ckflight/RF_SIGNAL_GENERATOR_HARDWARE/README.md

# RF_SIGNAL_GENERATOR_HARDWARE

MAX2871 23.5 to 6000MHz RF Signal Generator design with ATMEGA32U4 MCU, Filter Bank and Power Amplifier.

signal generator
