ckflight/RF_SIGNAL_GENERATOR_HARDWARE/RF Signal Generator.pdf

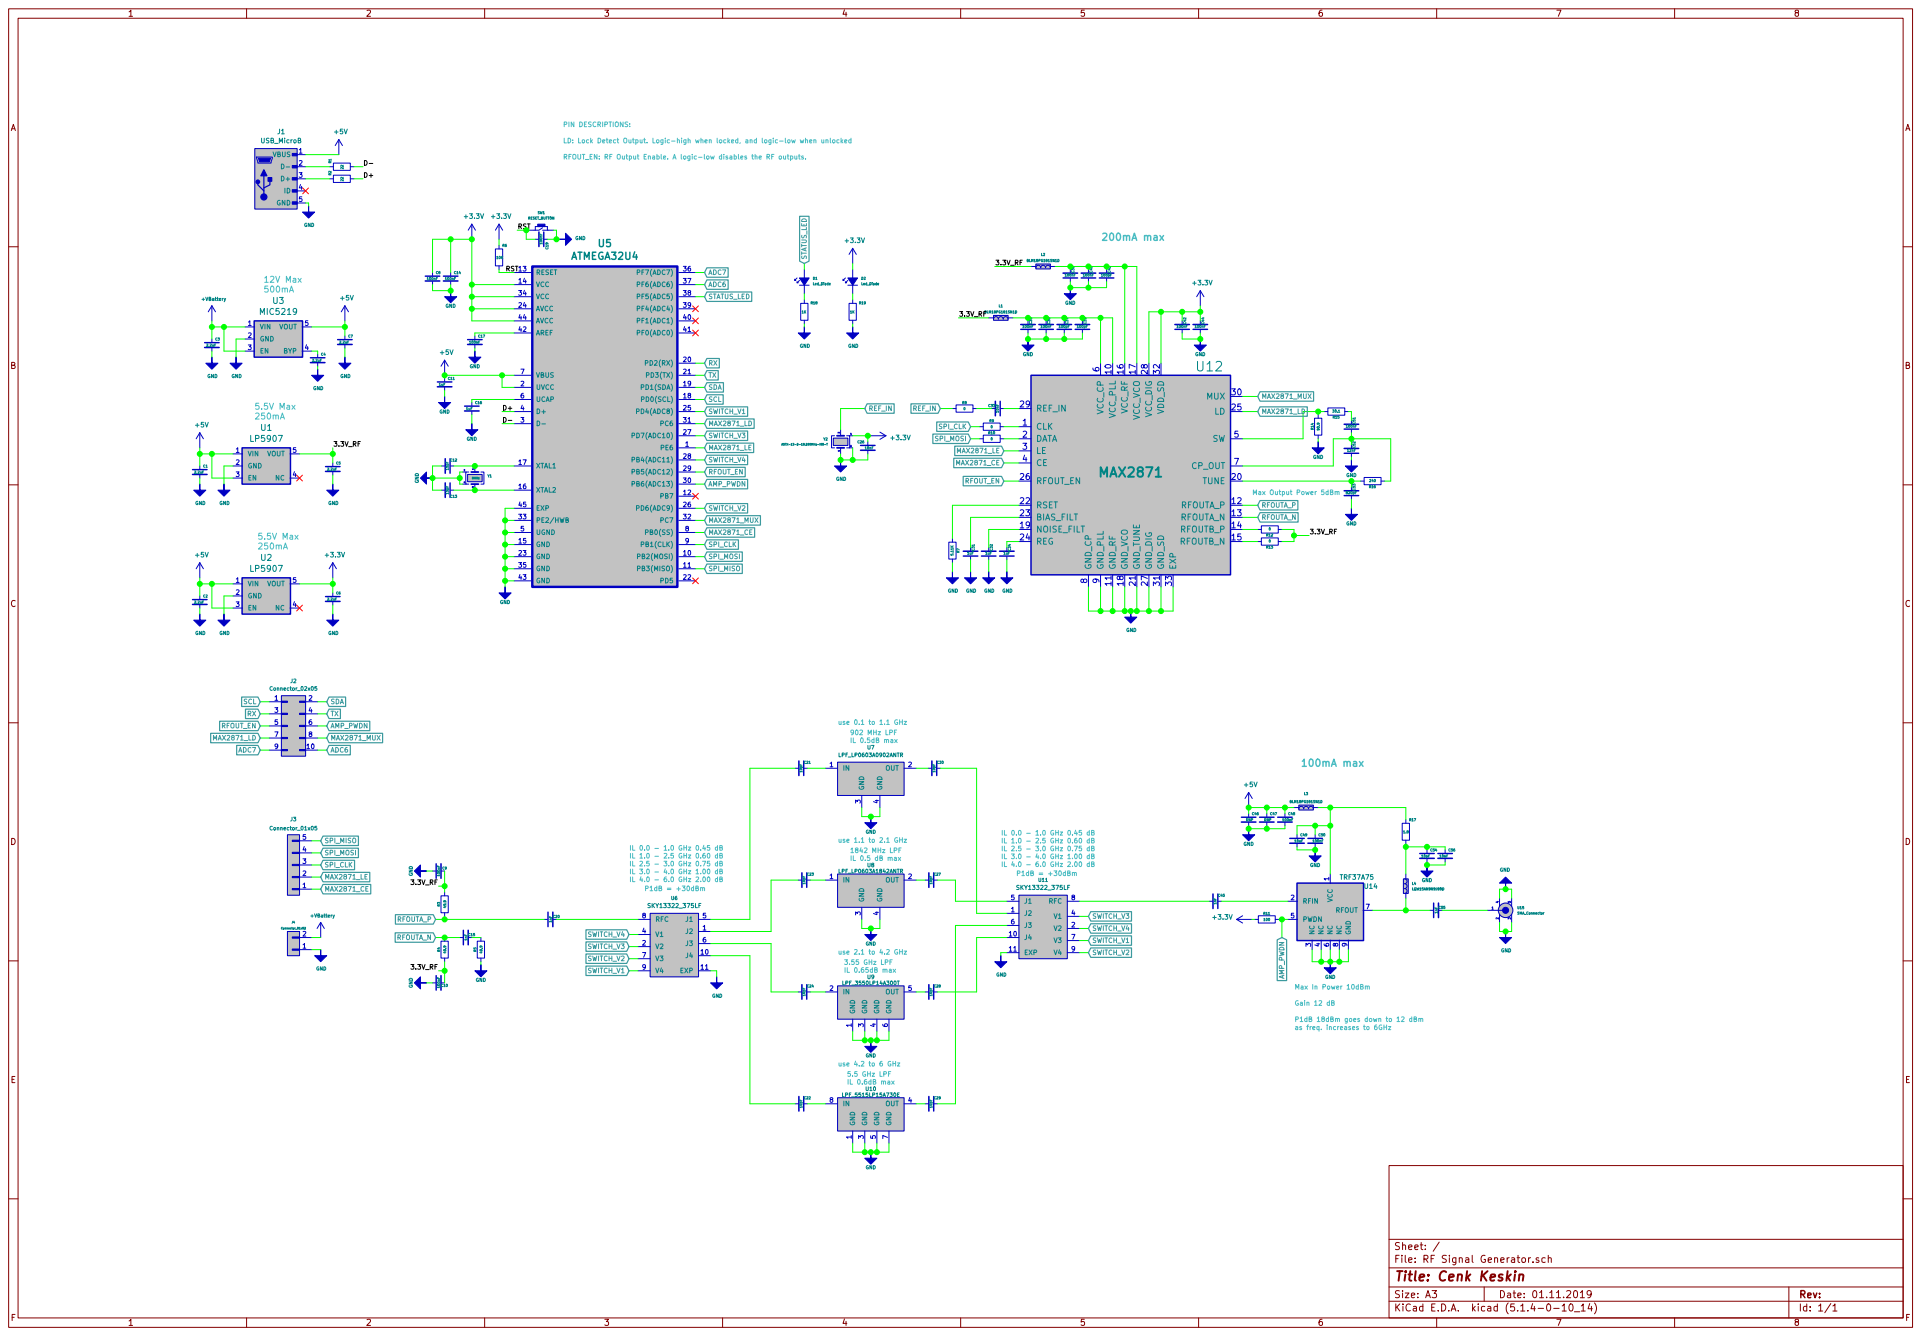
[picture p1: page 1]

PIN DESCRIPTIONS: LD: Lock Detect Output. Logic-high when locked, and logic-low when unlocked RFOUT_EN: RF Output Enable. A logic-low disables the RF outputs.

use 1.1 to 2.1 GHz 902 MHz LPF
IL 0.5dB max 5.5 GHz LPF

4 U7 LPF_LP0603A0902ANTR GND
use 4.2 to 6 GHz use 2.1 to 4.2 GHz 1842 MHz LPF
IL 0.5 dB max

P1dB 18dBm goes down to 12 dBm
as freq. increases to 6GHz

File: RF Signal Generator.sch Sheet: /
Id: 1/1 Title: Cenk Keskin
