ckflight/RF_SIGNAL_GENERATOR_HARDWARE/RF Signal Generator.kicad_pcb

## KiCad design RF Signal Generator.kicad_pcb (2020-02-22)

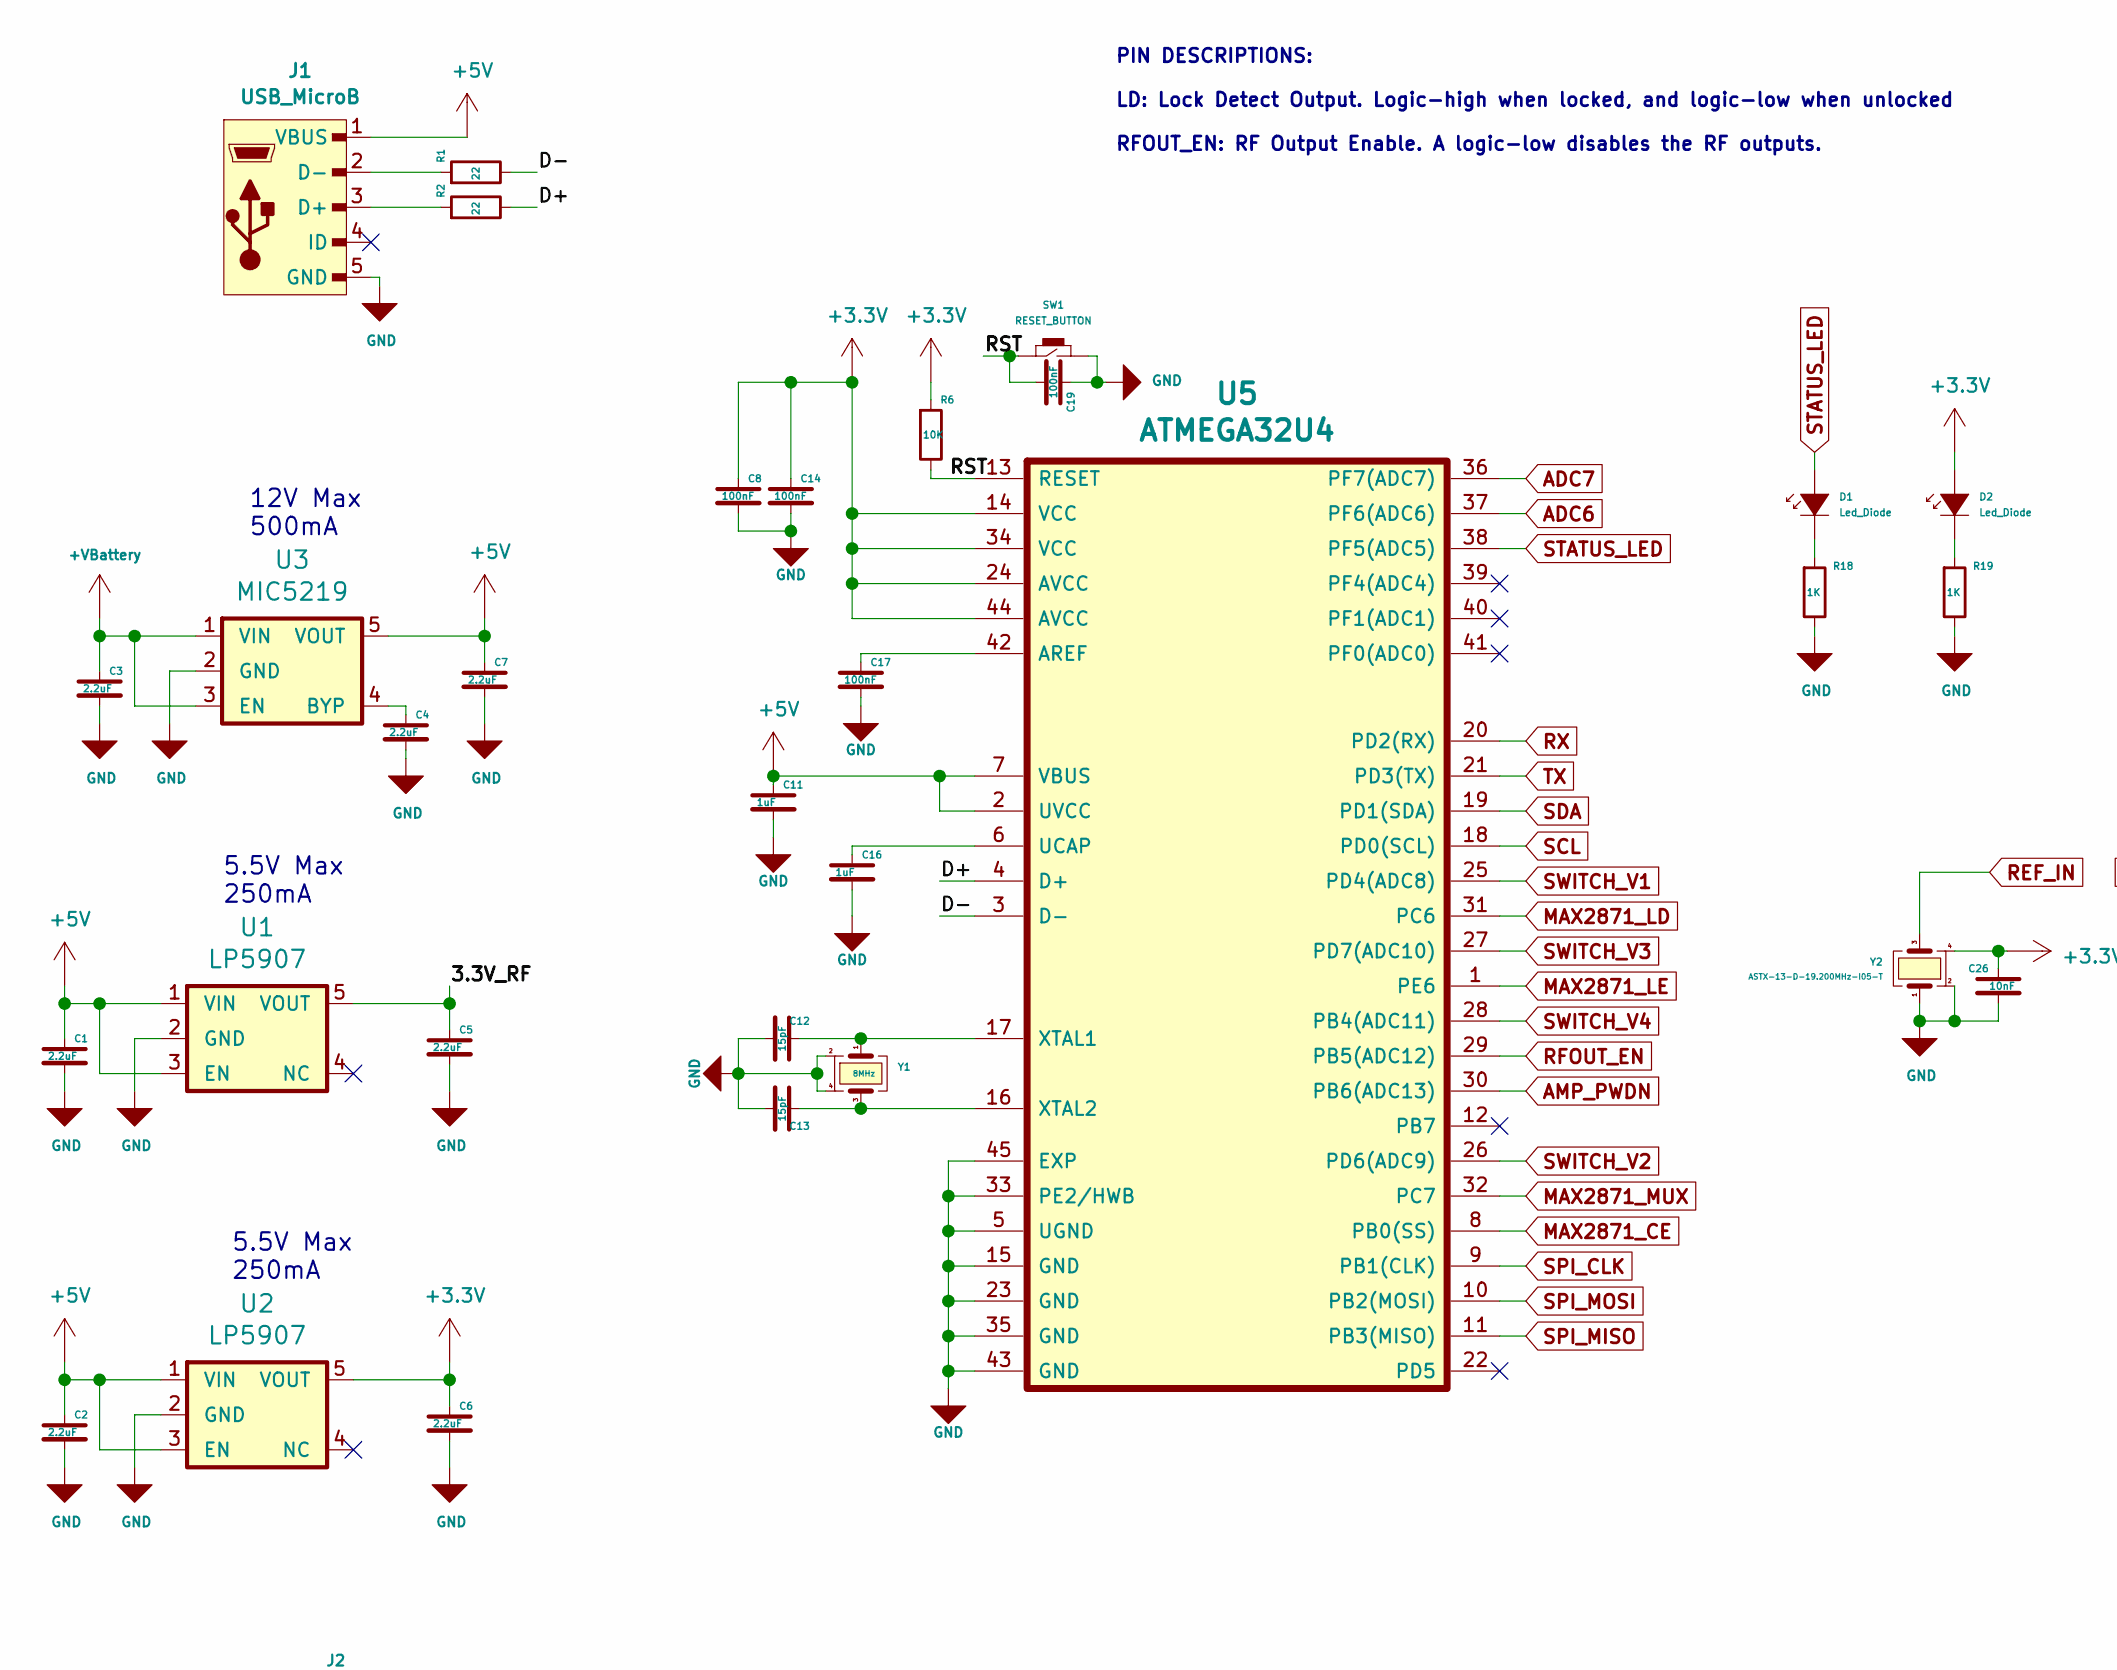
[picture p2: schematic RF Signal Generator.sch, Cenk Keskin, part in row 1, column 1]

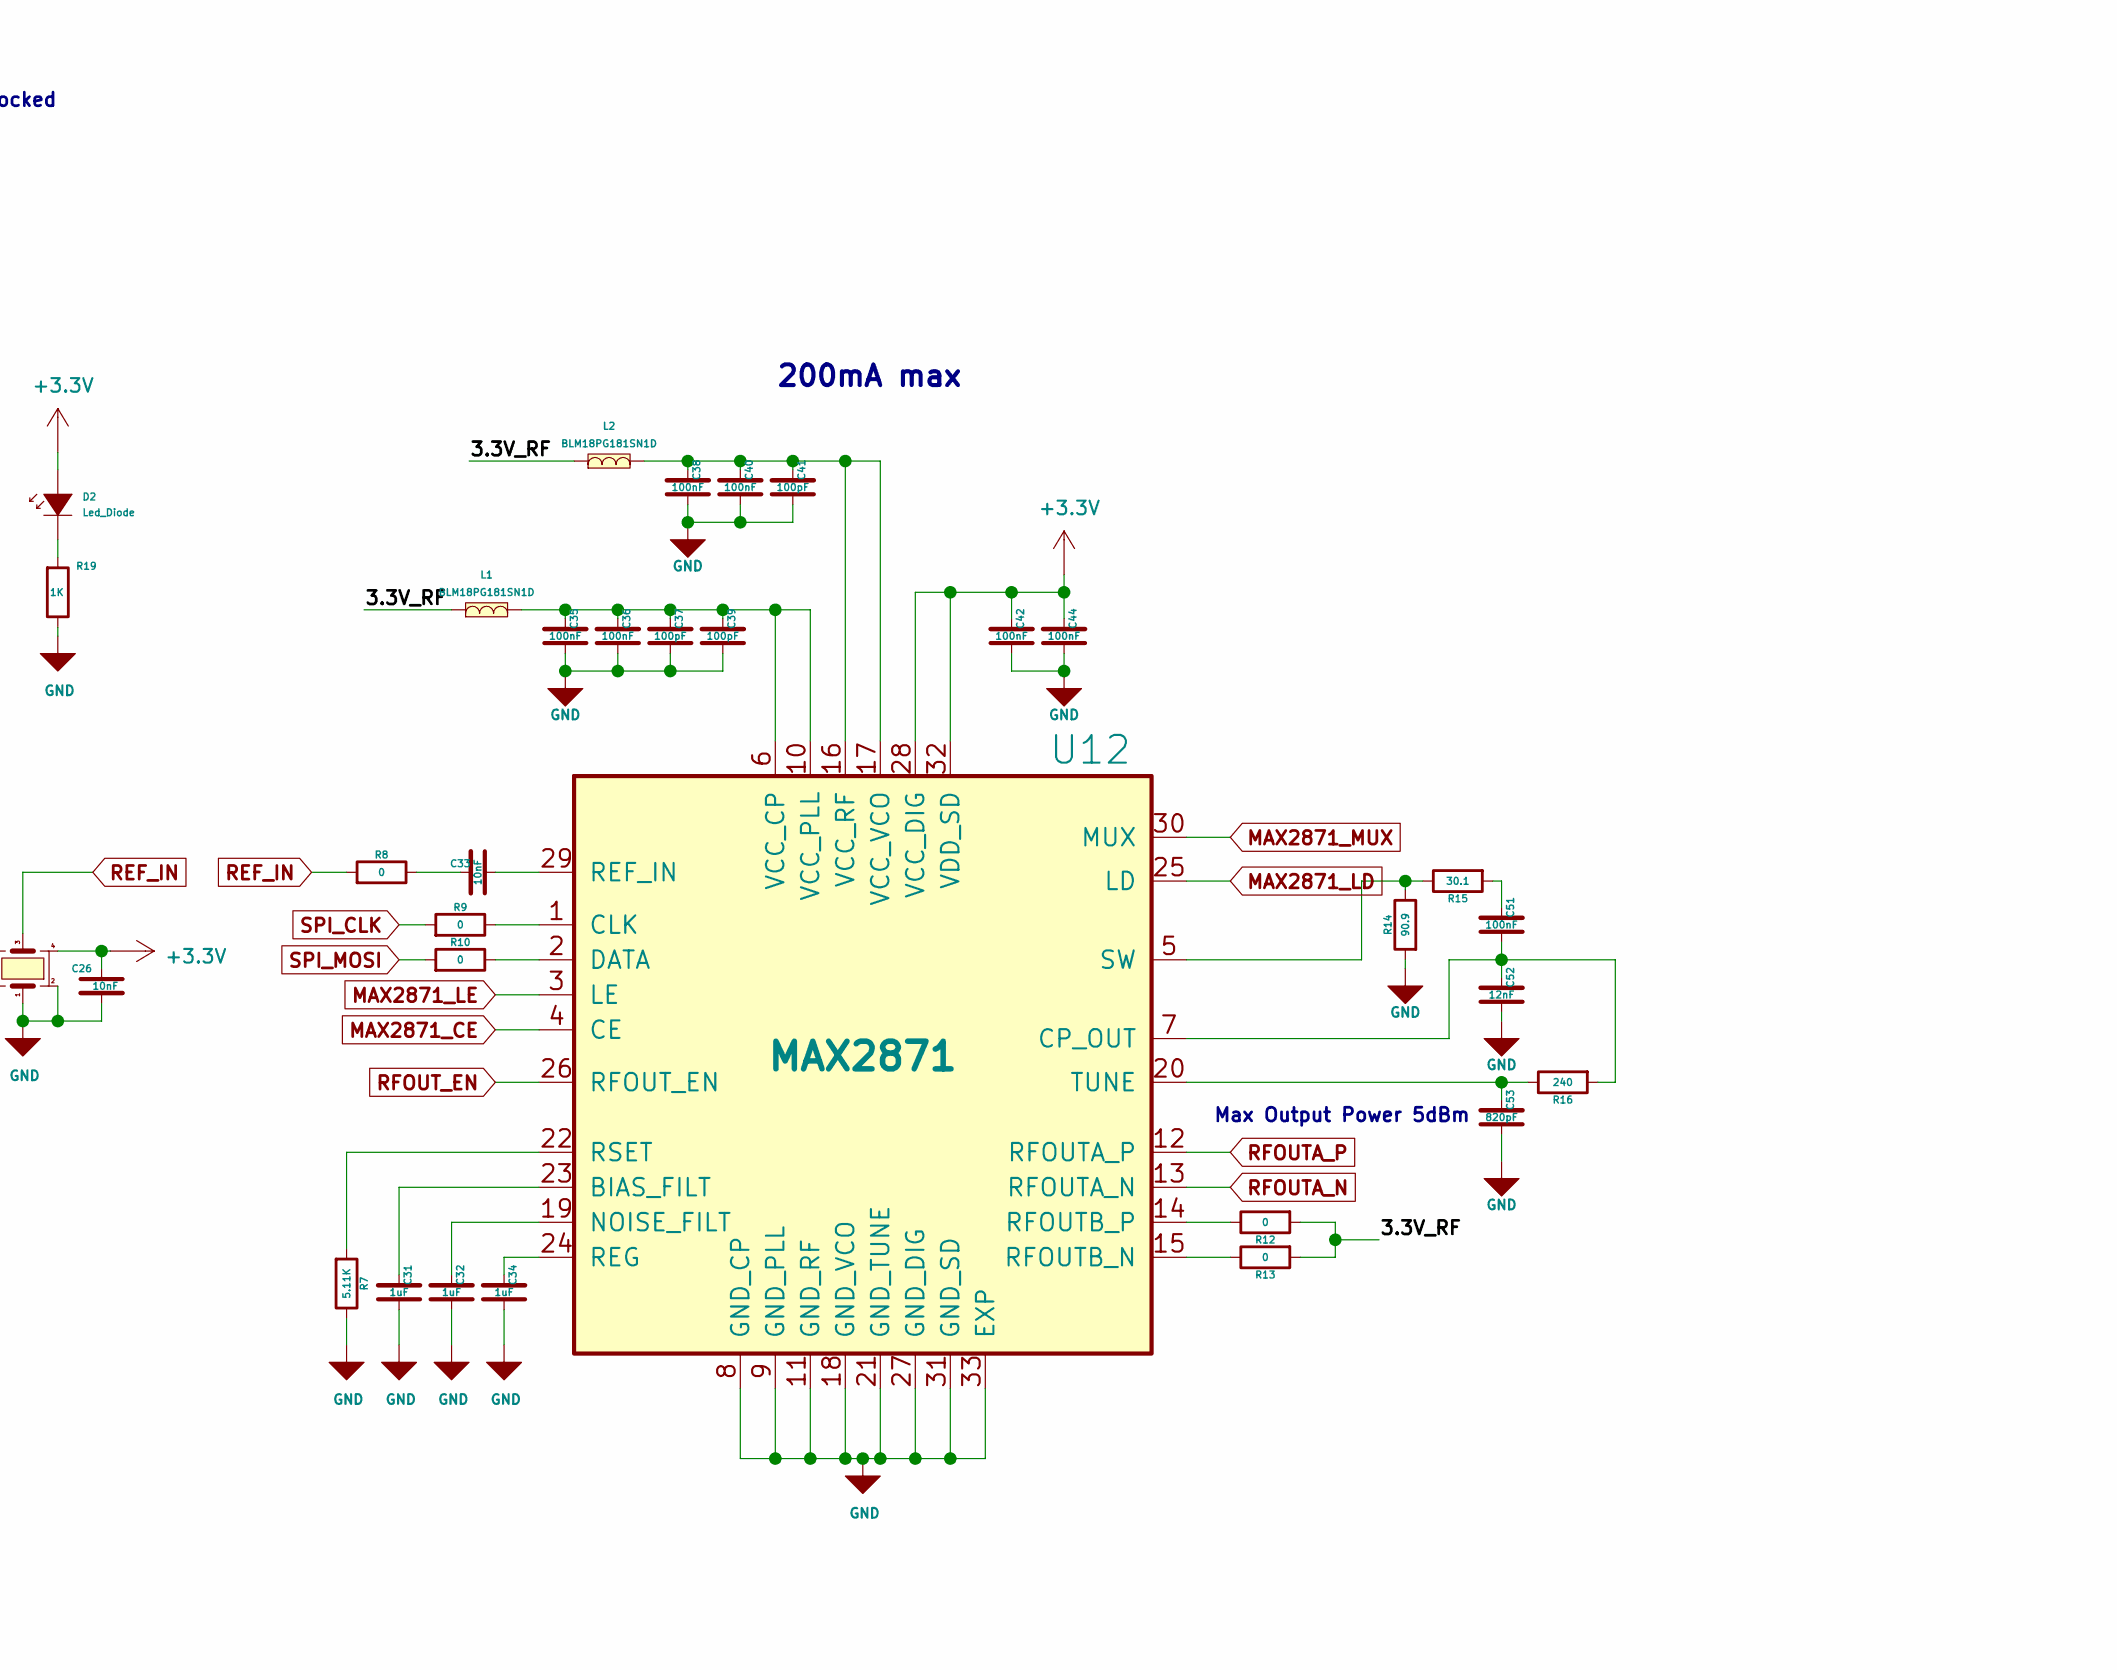
[picture p3: schematic RF Signal Generator.sch, Cenk Keskin, part in row 1, column 2]

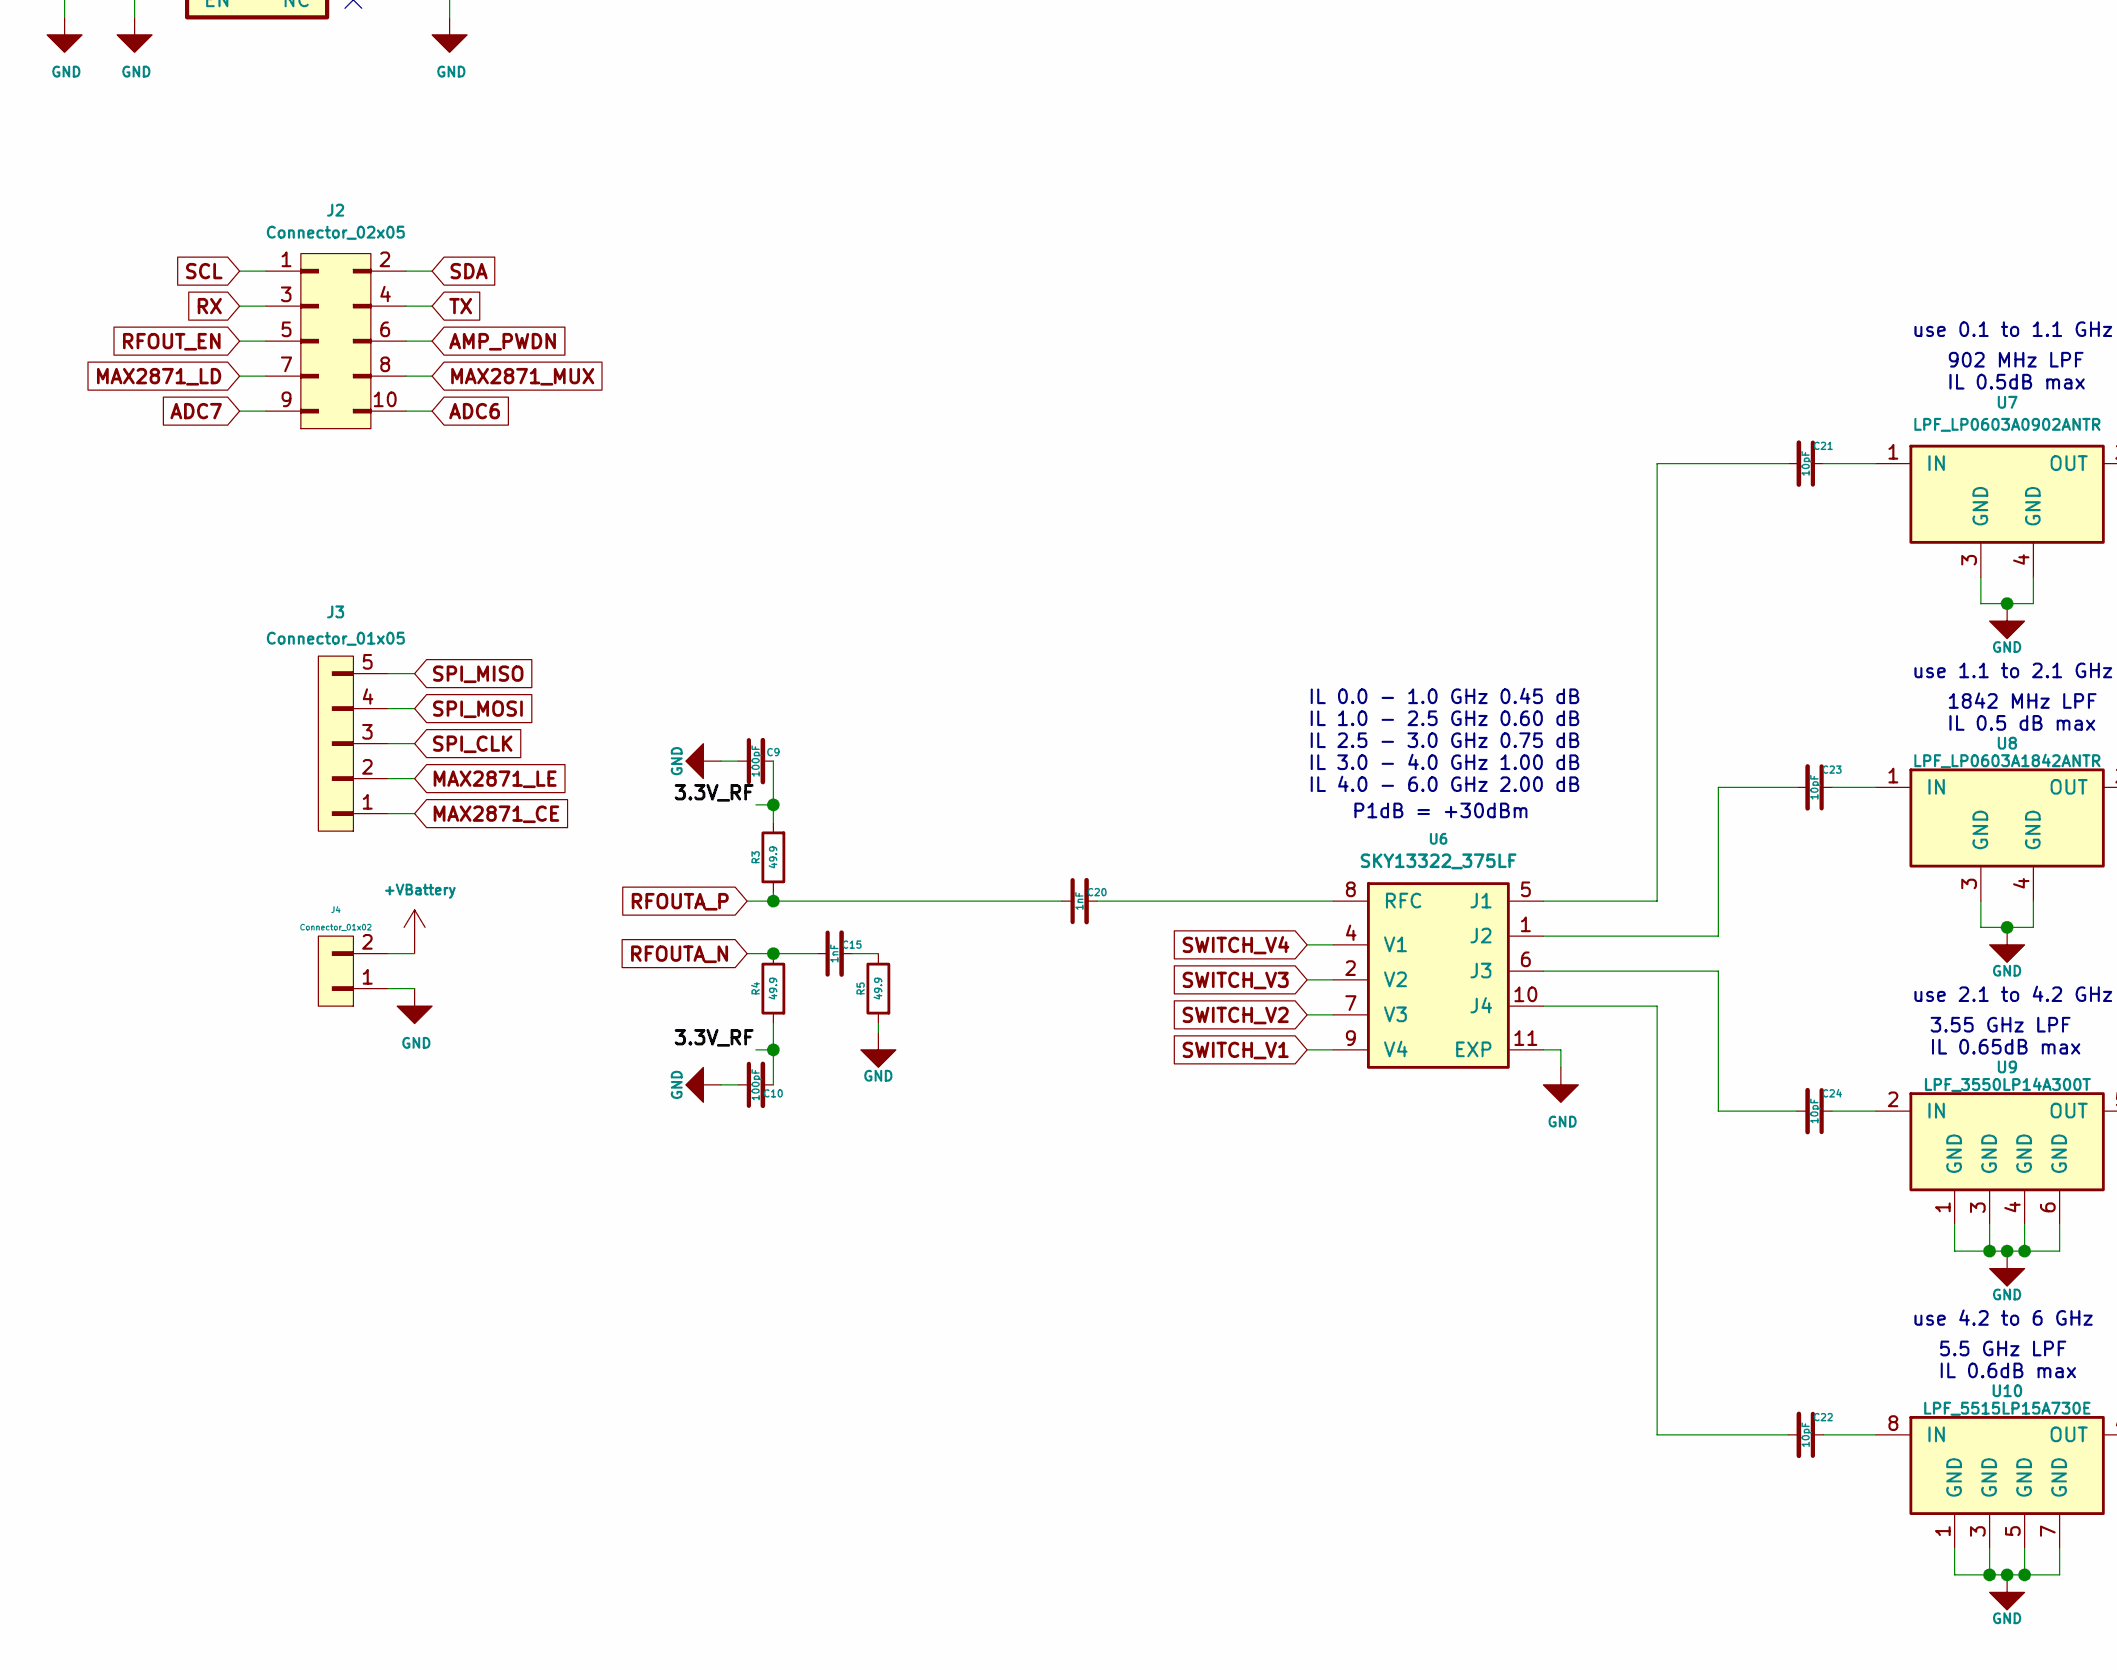
[picture p4: schematic RF Signal Generator.sch, Cenk Keskin, part in row 2, column 1]

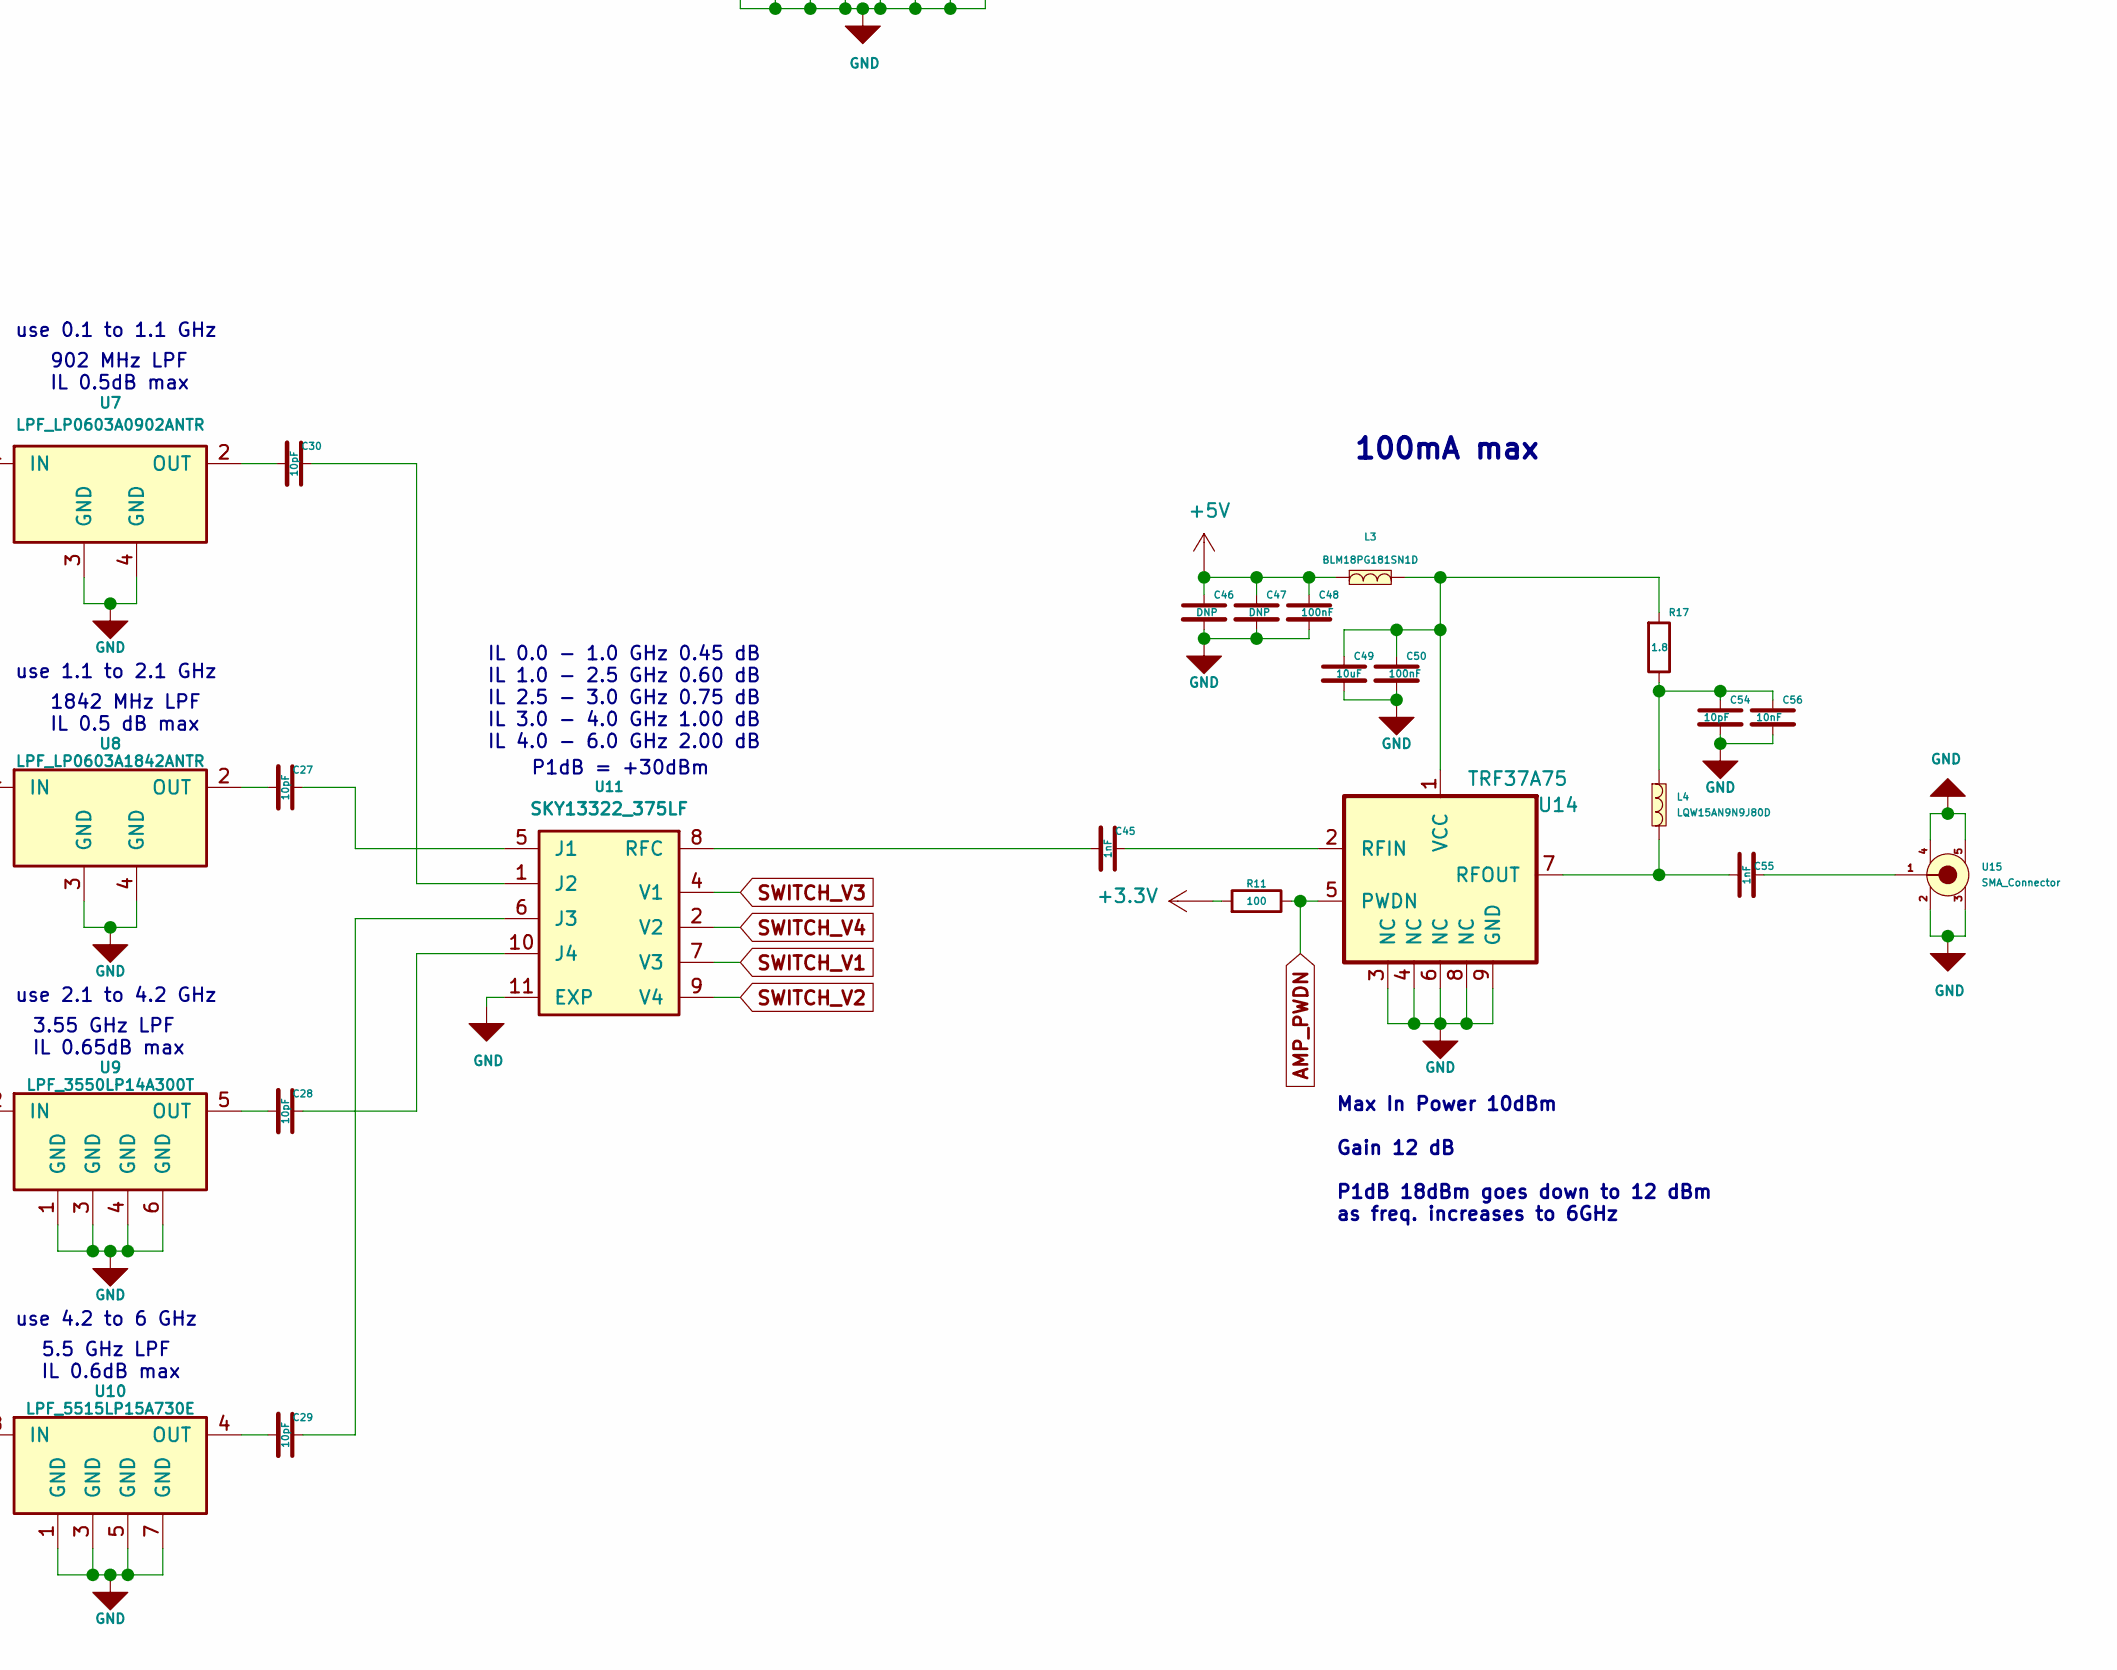
[picture p5: schematic RF Signal Generator.sch, Cenk Keskin, part in row 2, column 2]

Parts:
C1, C2, C3, C4, C5, C6, C7: 2.2uF; SMD_0402
C8, C14, C17, C19, C35, C36, C38, C40, C42, C44, C48, C50, C51: 100nF; SMD_0402
C9, C10, C37, C39, C41: 100pF; SMD_0402
C11, C16, C31, C32, C34: 1uF; SMD_0402
C12, C13: 15pF; SMD_0402
C15, C20, C45, C55: 1nF; SMD_0402
C21, C22, C23, C24, C27, C28, C29, C30, C54: 10pF; SMD_0402
C26, C33, C56: 10nF; SMD_0402
C46, C47: DNP; SMD_0402
C49: 10uF; SMD_0402
C52: 12nF; SMD_0402
C53: 820pF; SMD_0402
D1, D2: Led_Diode; Diode_0603
J1: USB_MicroB; USB_MicroB_TH
J2: Connector_02x05; PinHeader_2x5_P2.54mm
J3: Connector_01x05; PinHeader_1x5_P2.54mm
J4: Connector_01x02; PinHeader_1x2_P2.54mm
L1, L2, L3: BLM18PG181SN1D; SMD_0603
L4: LQW15AN9N9J80D; SMD_0402
R1, R2: 22; SMD_0402
R3, R4, R5: 49.9; SMD_0402
R6: 10K; SMD_0402
R7: 5.11K; SMD_0402
R8, R9, R10, R12, R13: 0; SMD_0402
R11: 100; SMD_0402
R14: 90.9; SMD_0402
R15: 30.1; SMD_0402
R16: 240; SMD_0402
R17: 1.8; SMD_0402
R18, R19: 1K; SMD_0402
SW1: RESET_BUTTON; Button_B3U_1000P
U1, U2: LP5907; SOT23_5
U3: MIC5219; SOT23_5
U5: ATMEGA32U4; QFN44_7x7mm_P0.5mm_1EXP_4.5x4.5mm
U6, U11: SKY13322_375LF; MLPD_10
U7: LPF_LP0603A0902ANTR
U8: LPF_LP0603A1842ANTR
U9: LPF_3550LP14A300T
U10: LPF_5515LP15A730E
U12: MAX2871; QFN32_5x5mm_P0.5mm_1EXP_3.1x3.1mm
U14: TRF37A75; WSON8_2x2mm_P0.5mm_1EXP_0.9x1.6mm
U15: SMA_Connector
Y1: 8MHz; Crystal_3.2x2.5mm
Y2: ASTX-13-D-19.200MHz-I05-T; Crystal_2x1.6mm

Connections:
+3V3: C6.1, C8.1, C14.1, C26.1, C42.2, C44.2, D2.2 (A), R6.1, R11.1, U2.5 (VOUT), U5.14 (VCC), U5.24 (AVCC), U5.34 (VCC), U5.44 (AVCC), U12.28 (VCC_DIG), U12.32 (VDD_SD), Y2.4; also elsewhere on the board
+5V: C1.1, C2.1, C7.1, C11.1, C46.1, C47.1, C48.1, J1.1 (VBUS), L3.1, U1.1 (VIN), U1.3 (EN), U2.1 (VIN), U2.3 (EN), U3.5 (VOUT), U5.2 (UVCC), U5.7 (VBUS)
+VBattery: C3.1, J4.2, U3.1 (VIN), U3.3 (EN)
/3.3V_RF: C5.1, C9.2, C10.2, L1.1, L2.1, R3.1, R4.1, R12.1, R13.1, U1.5 (VOUT)
/D+: R2.2, U5.4 (D+)
/D-: R1.2, U5.3 (D-)
/RST: C19.2, R6.2, SW1.1, U5.13 (RESET)
ADC6: J2.10, U5.37 (PF6(ADC6))
ADC7: J2.9, U5.36 (PF7(ADC7))
AMP_PWDN: J2.6, R11.2, U5.30 (PB6(ADC13)), U14.5 (PWDN)
GND: C1.2, C2.2, C3.2, C4.2, C5.2, C6.2, C7.2, C8.2, C9.1, C10.1, C11.2, C12.2, C13.2, C14.2, C16.2, C17.2, C19.1, C26.2, C31.1, C32.1, C34.1, C35.1, C36.1, C37.1, C38.1, C39.1, C40.1, C41.1, C42.1, C44.1, C46.2, C47.2, C48.2, C49.2, C50.2, C52.1, C53.1, C54.2, C56.2, J1.5 (GND), J4.1, R5.1, R7.2, R14.1, R18.2, R19.2, SW1.2, U1.2 (GND), U2.2 (GND), U3.2 (GND), U5.5 (UGND), U5.15 (GND), U5.23 (GND), U5.33 (PE2/HWB), U5.35 (GND), U5.43 (GND), U5.45 (EXP), U6.11 (EXP), U7.3 (GND), U7.4 (GND), U8.3 (GND), U8.4 (GND), U9.1 (GND), U9.3 (GND), U9.4 (GND), U9.6 (GND), U10.1 (GND), U10.3 (GND), U10.5 (GND), U10.7 (GND), U11.11 (EXP), U12.8 (GND_CP), U12.9 (GND_PLL), U12.11 (GND_RF), U12.18 (GND_VCO), U12.21 (GND_TUNE), U12.27 (GND_DIG), U12.31 (GND_SD), U12.33 (EXP), U14.3 (NC), U14.4 (NC), U14.6 (NC), U14.8 (NC), U14.9 (GND), U15.2, U15.3, U15.4, U15.5, Y1.2, Y1.4, Y2.1, Y2.2
MAX2871_CE: J3.1, U5.8 (PB0(SS)), U12.4 (CE)
MAX2871_LD: J2.7, U5.31 (PC6), U12.25 (LD)
MAX2871_LE: J3.2, U5.1 (PE6), U12.3 (LE)
MAX2871_MUX: J2.8, U5.32 (PC7), U12.30 (MUX)
unnamed: C4.1, U3.4 (BYP)
unnamed: C12.1, U5.17 (XTAL1), Y1.1
unnamed: C13.1, U5.16 (XTAL2), Y1.3
unnamed: C15.2, R5.2
unnamed: C16.1, U5.6 (UCAP)
unnamed: C17.1, U5.42 (AREF)
unnamed: C20.2, U6.8 (RFC)
unnamed: C21.1, U7.1 (IN)
unnamed: C21.2, U6.5 (J1)
unnamed: C22.1, U10.8 (IN)
unnamed: C22.2, U6.10 (J4)
unnamed: C23.1, U8.1 (IN)
unnamed: C23.2, U6.1 (J2)
unnamed: C24.1, U9.2 (IN)
unnamed: C24.2, U6.6 (J3)
unnamed: C27.1, U11.5 (J1)
unnamed: C27.2, U8.2 (OUT)
unnamed: C28.1, U11.10 (J4)
unnamed: C28.2, U9.5 (OUT)
unnamed: C29.1, U11.6 (J3)
unnamed: C29.2, U10.4 (OUT)
unnamed: C30.1, U11.1 (J2)
unnamed: C30.2, U7.2 (OUT)
unnamed: C31.2, U12.23 (BIAS_FILT)
unnamed: C32.2, U12.19 (NOISE_FILT)
unnamed: C33.1, U12.29 (REF_IN)
unnamed: C33.2, R8.2
unnamed: C34.2, U12.24 (REG)
unnamed: C35.2, C36.2, C37.2, C39.2, L1.2, U12.6 (VCC_CP), U12.10 (VCC_PLL)
unnamed: C38.2, C40.2, C41.2, L2.2, U12.16 (VCC_RF), U12.17 (VCC_VCO)
unnamed: C45.1, U14.2 (RFIN)
unnamed: C45.2, U11.8 (RFC)
unnamed: C49.1, C50.1, L3.2, R17.1, U14.1 (VCC)
unnamed: C51.1, C52.2, R16.1, U12.7 (CP_OUT)
unnamed: C51.2, R15.1
unnamed: C53.2, R16.2, U12.20 (TUNE)
unnamed: C54.1, C56.1, L4.1, R17.2
unnamed: C55.1, L4.2, U14.7 (RFOUT)
unnamed: C55.2, U15.1
unnamed 54: D1.1 (K), R18.1; also elsewhere on the board
unnamed 55: D2.1 (K), R19.1; also elsewhere on the board
unnamed: J1.2 (D-), R1.1
unnamed: J1.3 (D+), R2.1
unnamed: R7.1, U12.22 (RSET)
unnamed: R9.2, U12.1 (CLK)
unnamed: R10.2, U12.2 (DATA)
unnamed: R12.2, U12.14 (RFOUTB_P)
unnamed: R13.2, U12.15 (RFOUTB_N)
unnamed: R14.2, R15.2, U12.5 (SW)
REF_IN: R8.1, Y2.3
RFOUTA_N: C15.1, R4.2, U12.13 (RFOUTA_N)
RFOUTA_P: C20.1, R3.2, U12.12 (RFOUTA_P)
RFOUT_EN: J2.5, U5.29 (PB5(ADC12)), U12.26 (RFOUT_EN)
RX: J2.3, U5.20 (PD2(RX))
SCL: J2.1, U5.18 (PD0(SCL))
SDA: J2.2, U5.19 (PD1(SDA))
SPI_CLK: J3.3, R9.1, U5.9 (PB1(CLK))
SPI_MISO: J3.5, U5.11 (PB3(MISO))
SPI_MOSI: J3.4, R10.1, U5.10 (PB2(MOSI))
STATUS_LED: D1.2 (A), U5.38 (PF5(ADC5)); also elsewhere on the board
SWITCH_V1: U5.25 (PD4(ADC8)), U6.9 (V4), U11.7 (V3)
SWITCH_V2: U5.26 (PD6(ADC9)), U6.7 (V3), U11.9 (V4)
SWITCH_V3: U5.27 (PD7(ADC10)), U6.2 (V2), U11.4 (V1)
SWITCH_V4: U5.28 (PB4(ADC11)), U6.4 (V1), U11.2 (V2)
TX: J2.4, U5.21 (PD3(TX))

Notes on the sheet:
Max Output Power 5dBm
Max In Power 10dBm Gain 12 dB P1dB 18dBm goes down to 12 dBm as freq. increases to 6GHz
200mA max
100mA max
12V Max 500mA
5.5V Max 250mA
PIN DESCRIPTIONS: LD: Lock Detect Output. Logic-high when locked, and logic-low when unlocked RFOUT_EN: RF Output Enable. A logic-low disables the RF outputs.
3.55 GHz LPF IL 0.65dB max
5.5 GHz LPF IL 0.6dB max
902 MHz LPF IL 0.5dB max
P1dB = +30dBm
use 0.1 to 1.1 GHz
use 1.1 to 2.1 GHz
1842 MHz LPF IL 0.5 dB max
use 2.1 to 4.2 GHz
use 4.2 to 6 GHz
IL 0.0 - 1.0 GHz 0.45 dB IL 1.0 - 2.5 GHz 0.60 dB IL 2.5 - 3.0 GHz 0.75 dB IL 3.0 - 4.0 GHz 1.00 dB IL 4.0 - 6.0 GHz 2.00 dB

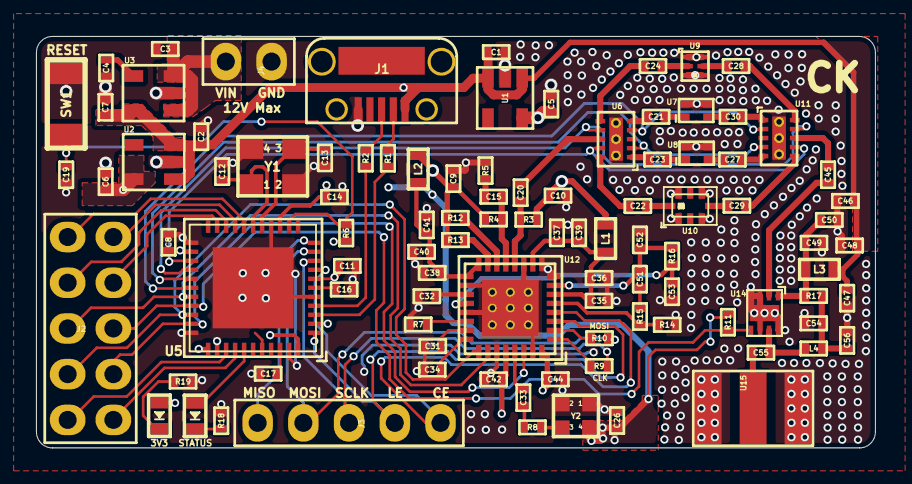
[picture p6: board RF Signal Generator.kicad_pcb from above]

Board: 4 copper layers, 46.6 x 22.9 mm, 98 parts (0 on the bottom side), 80 nets.

Other parts of the board:
3V3: Led_Diode; Diode_0603
STATUS: Led_Diode; Diode_0603

Their connections:
+3V3: 3V3.2; also elsewhere on the board
unnamed 54: STATUS.1; also elsewhere on the board
unnamed 55: 3V3.1; also elsewhere on the board
STATUS_LED: STATUS.2; also elsewhere on the board
